Arturrito63/ST7789-Terminal/Doc/Componentes.jpg

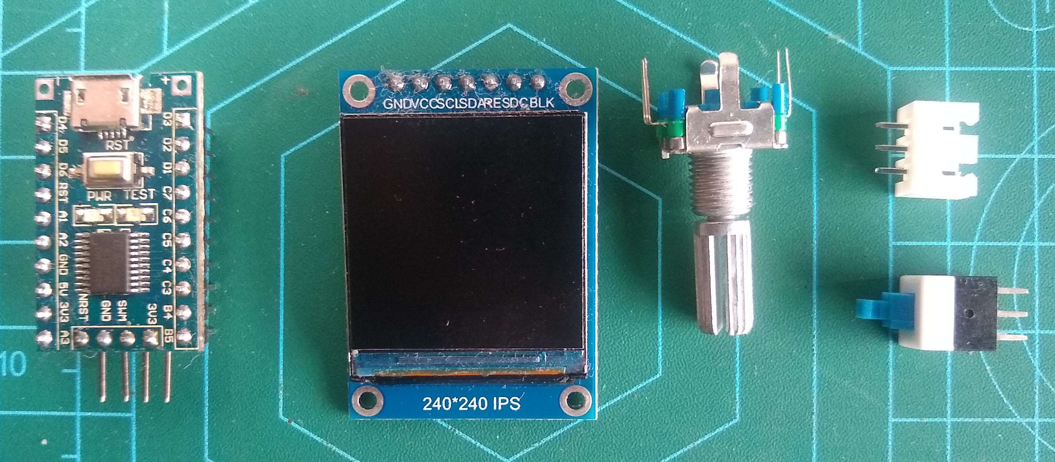
Doc/Componentes.jpg
