Arturrito63/ST7789-Terminal/(list of files, cad)

Other CAD files:
st7789-terminal.stp
