Arturrito63/ST7789-Terminal/Doc/STM8S103-LCD-Terminal.pdf

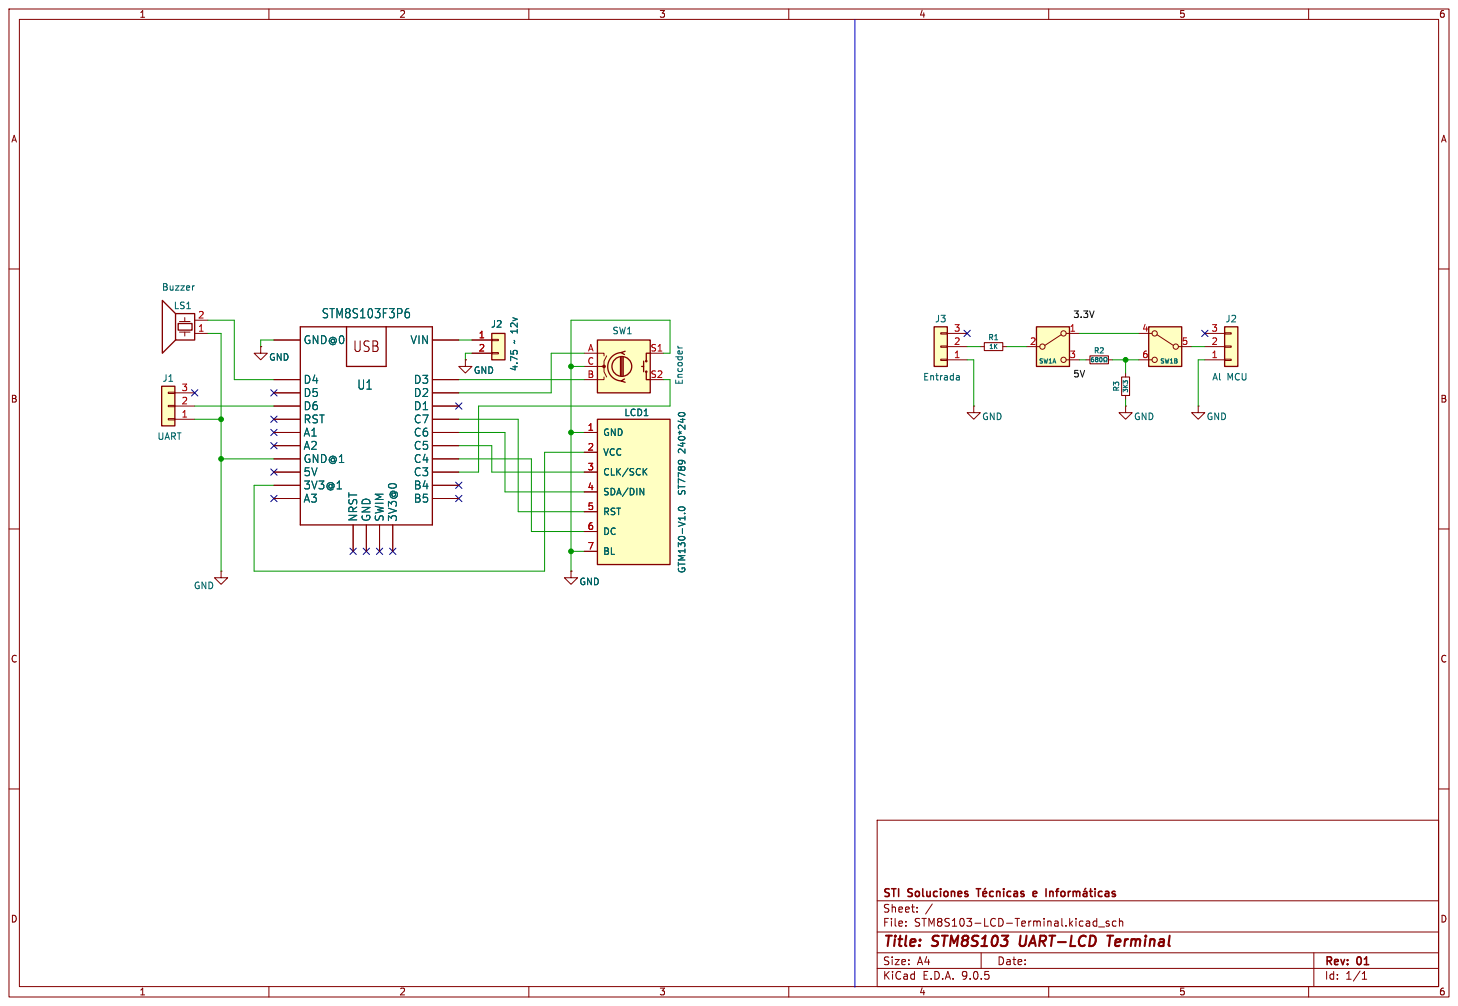
[picture p7: page 1]

C7 D1 D2 D3 VIN NRST GND SWIM 3V3@0 A3
