Arturrito63/ST7789-Terminal/Doc/Montaje.jpg

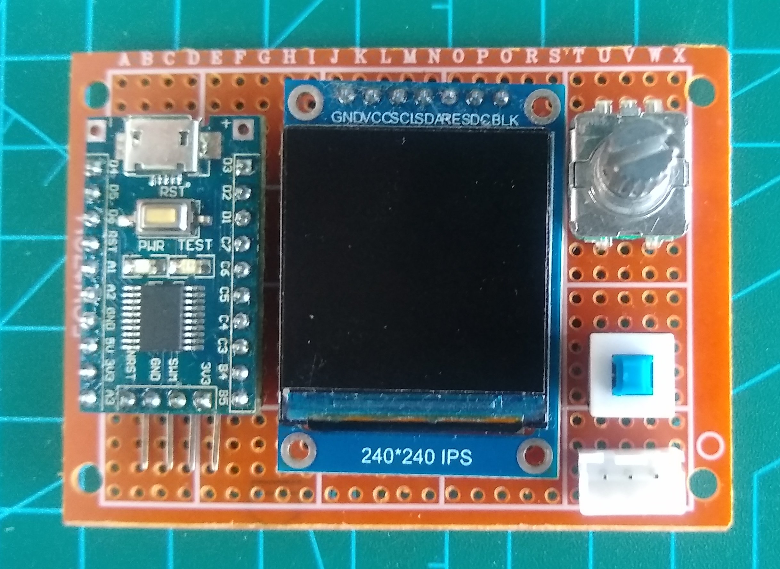
Doc/Montaje.jpg
